UbiTrich/home-assistant-poe-satellite/hardware/dps_v0/pics/BakALLIN.png

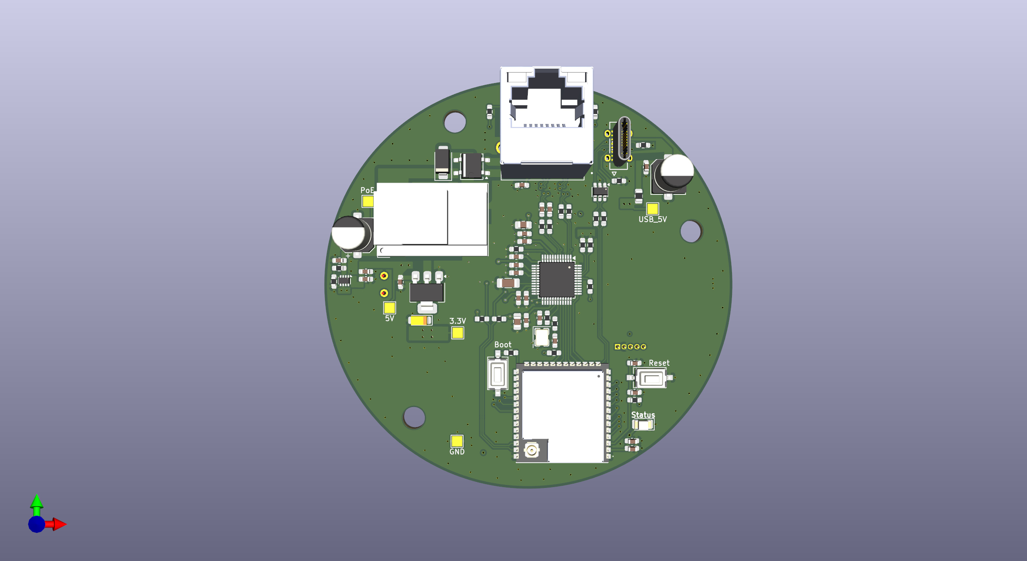
hardware/dps_v0/pics/BakALLIN.png
