UbiTrich/home-assistant-poe-satellite/hardware/dps_v0/pics/BakPOKUSYgg.png

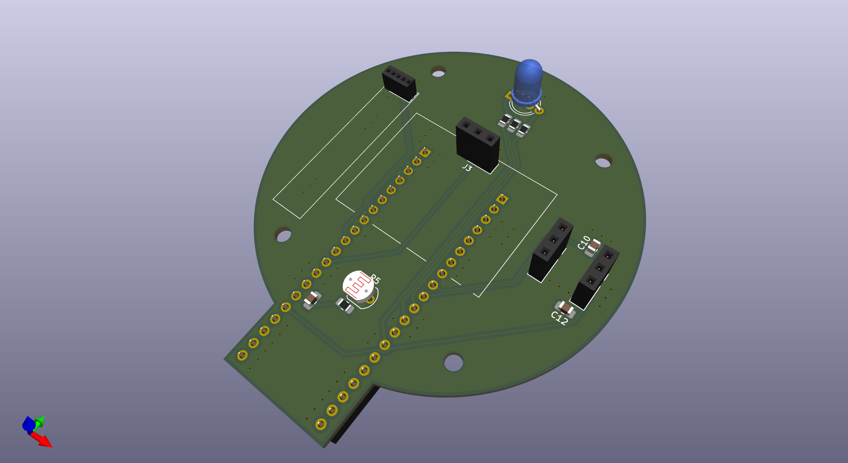
hardware/dps_v0/pics/BakPOKUSYgg.png
