UbiTrich/home-assistant-poe-satellite/hardware/dps_v0/dps_v0.png

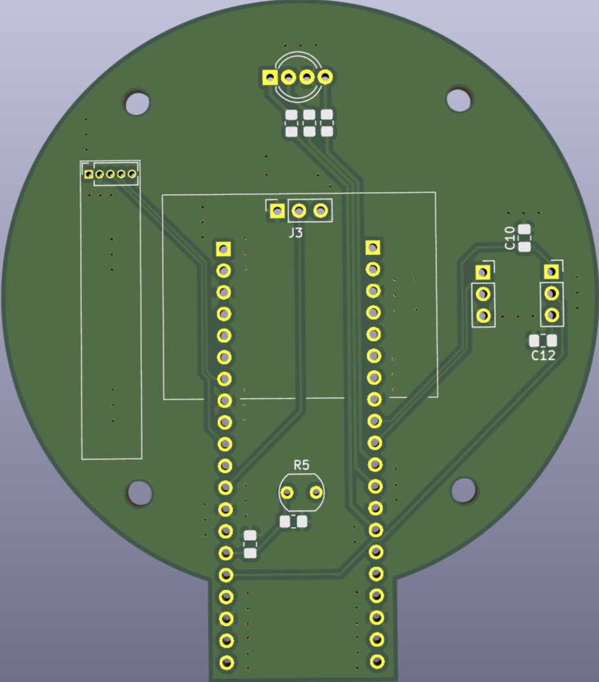
hardware/dps_v0/dps_v0.png
