UbiTrich/home-assistant-poe-satellite/hardware/dps_v0/pics/BAK.png

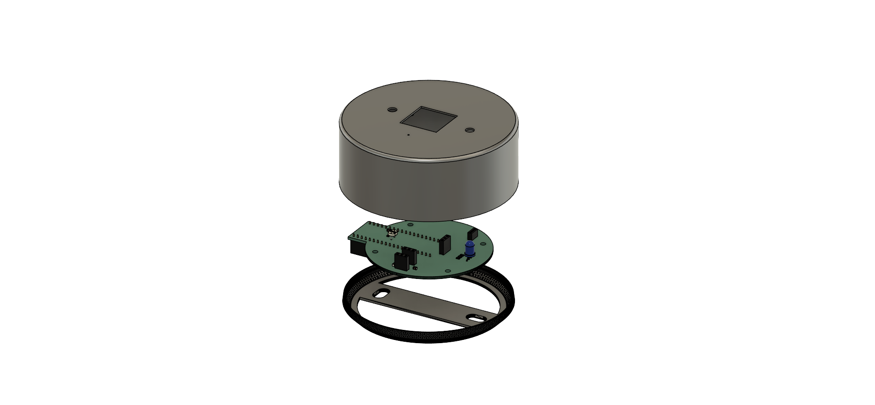
hardware/dps_v0/pics/BAK.png
