UbiTrich/home-assistant-poe-satellite/hardware/dps_v0/pics/BAKKK.png

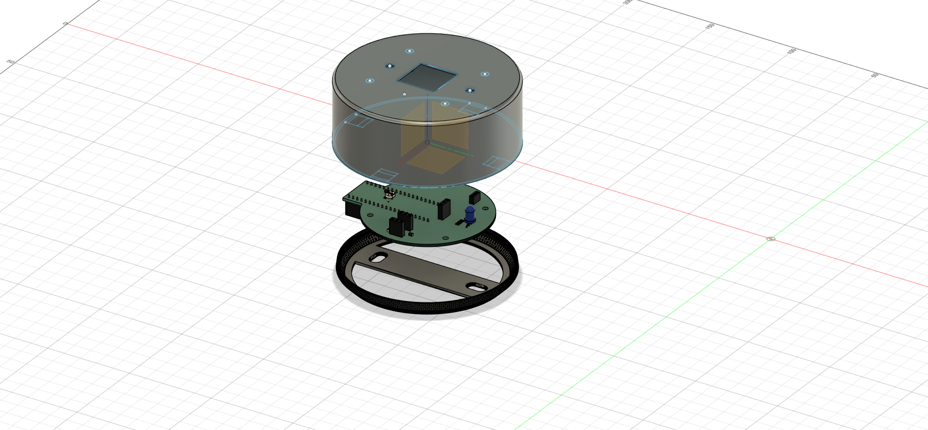
hardware/dps_v0/pics/BAKKK.png
