UbiTrich/home-assistant-poe-satellite/hardware/dps_v0/pics/schema_napajania.png

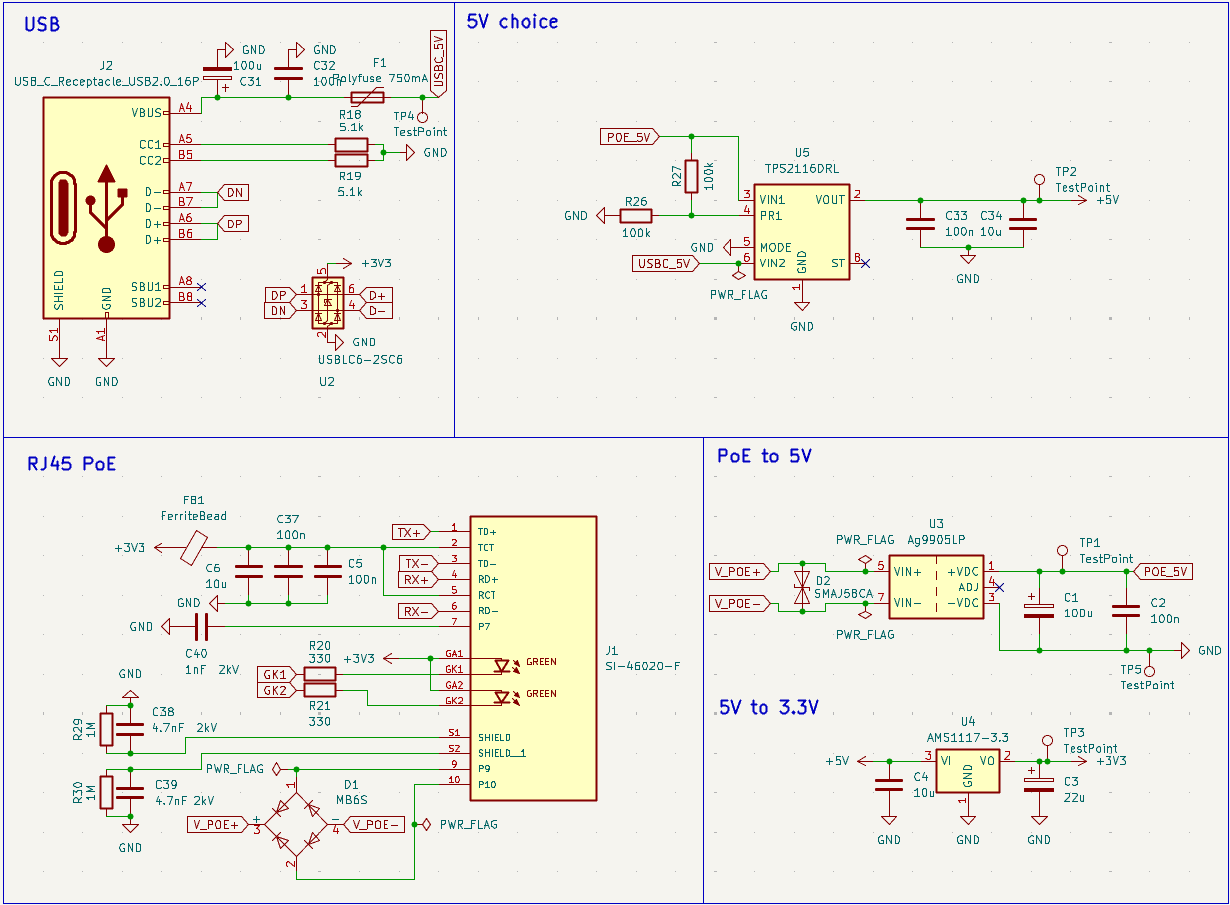
hardware/dps_v0/pics/schema_napajania.png
