UbiTrich/home-assistant-poe-satellite/hardware/dps_v0/pics/Screenshot 2026-03-11 211105.png

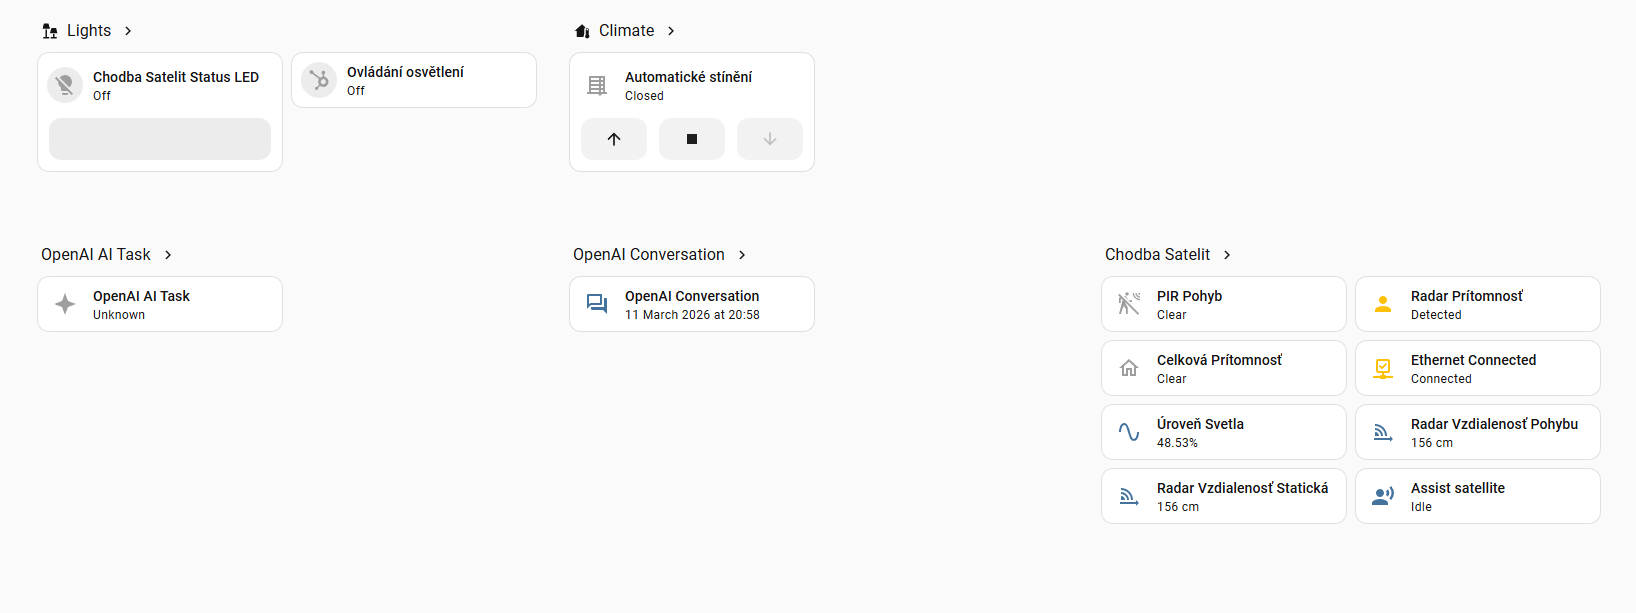
hardware/dps_v0/pics/Screenshot 2026-03-11 211105.png
