UbiTrich/home-assistant-poe-satellite/hardware/dps_v0/pics/Screenshot 2026-05-17 192225.png

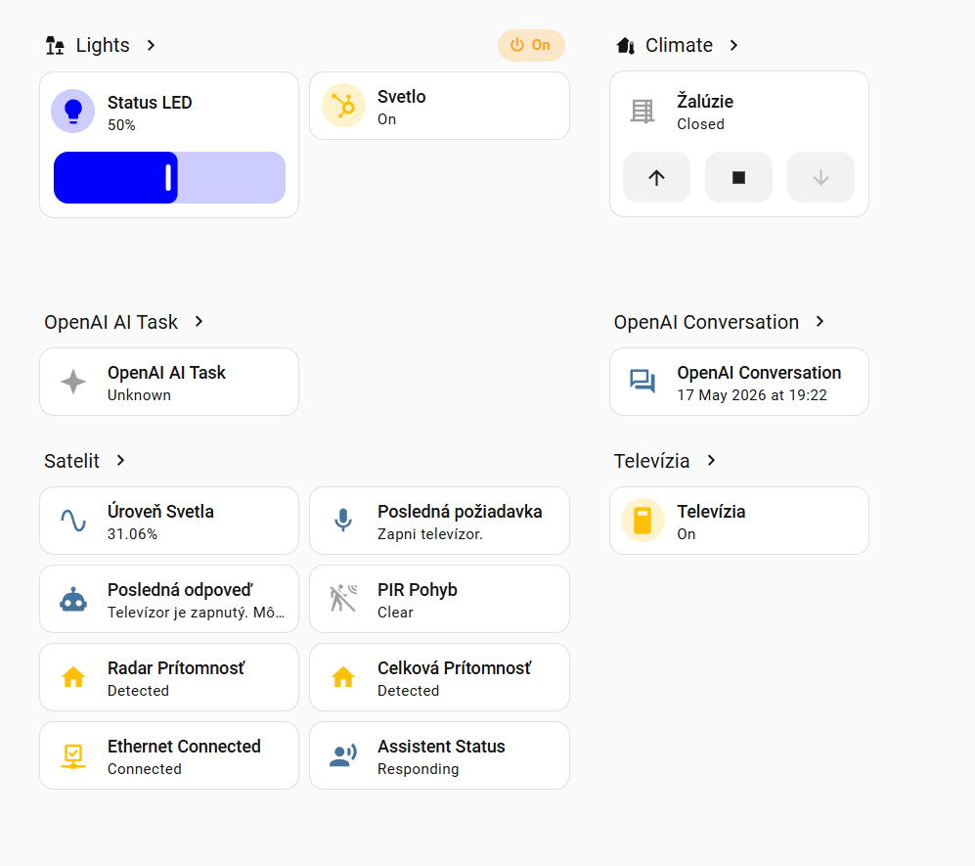
hardware/dps_v0/pics/Screenshot 2026-05-17 192225.png
