UbiTrich/home-assistant-poe-satellite/hardware/dps_v0/pics/W5500_Module.png

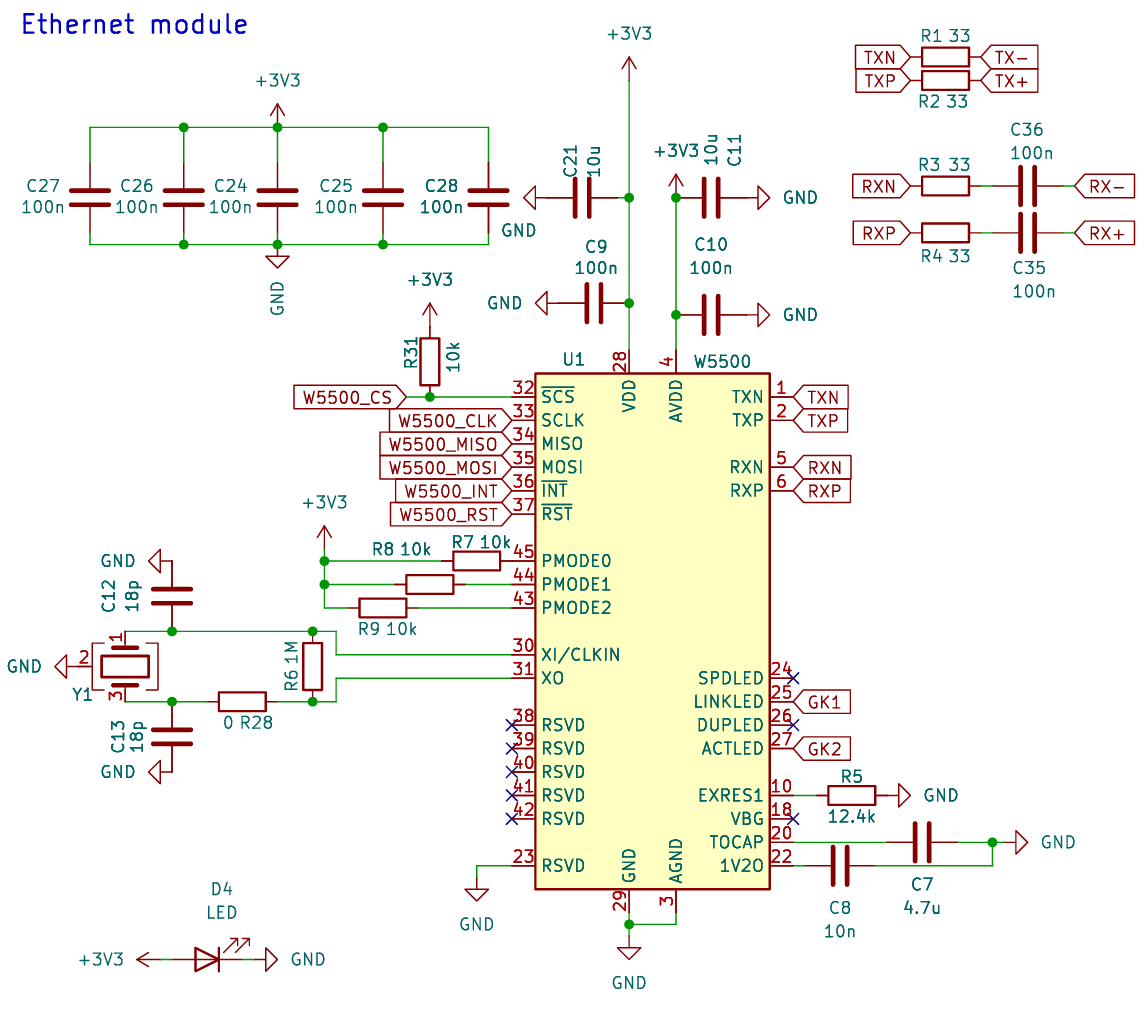
hardware/dps_v0/pics/W5500_Module.png
