UbiTrich/home-assistant-poe-satellite/enclosures/box_3d_model_print.stl

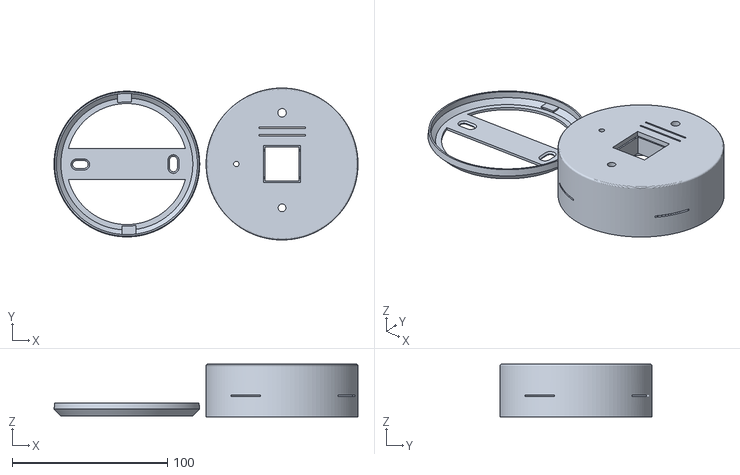
[picture p16: CAD file, 2026-05-22]
enclosures/box_3d_model_print.stl
196.0 x 98.0 x 34.0
