UbiTrich/home-assistant-poe-satellite/hardware/dps_v0/dps_v0.step

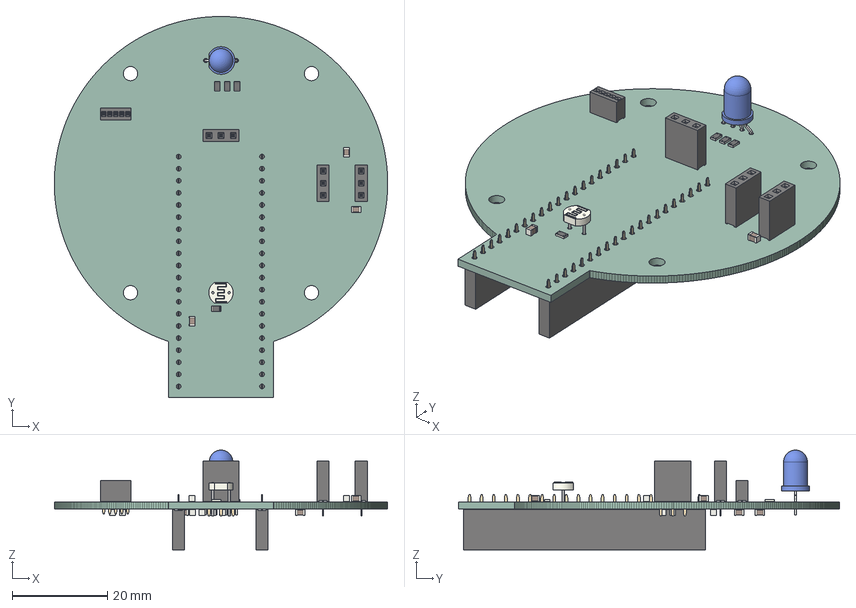
[picture p17: CAD file, 2026-05-29]
hardware/dps_v0/dps_v0.step
70.0 x 80.0 x 21.0 mm
C_0805_2012Metric x 12
PinSocket_1x03_P2.54mm_Vertical x 3
R_LDR_5.1x4.3mm_P3.4mm_Vertical
R_0805_2012Metric x 4
LED_D5.0mm-4_RGB_Wide_Pins
PinSocket_1x05_P1.27mm_Vertical
PinSocket_1x20_P2.54mm_Vertical x 2
BakPOKUSY_PCB
