UbiTrich/home-assistant-poe-satellite/hardware/dps_satelite/dps_satelite.pdf

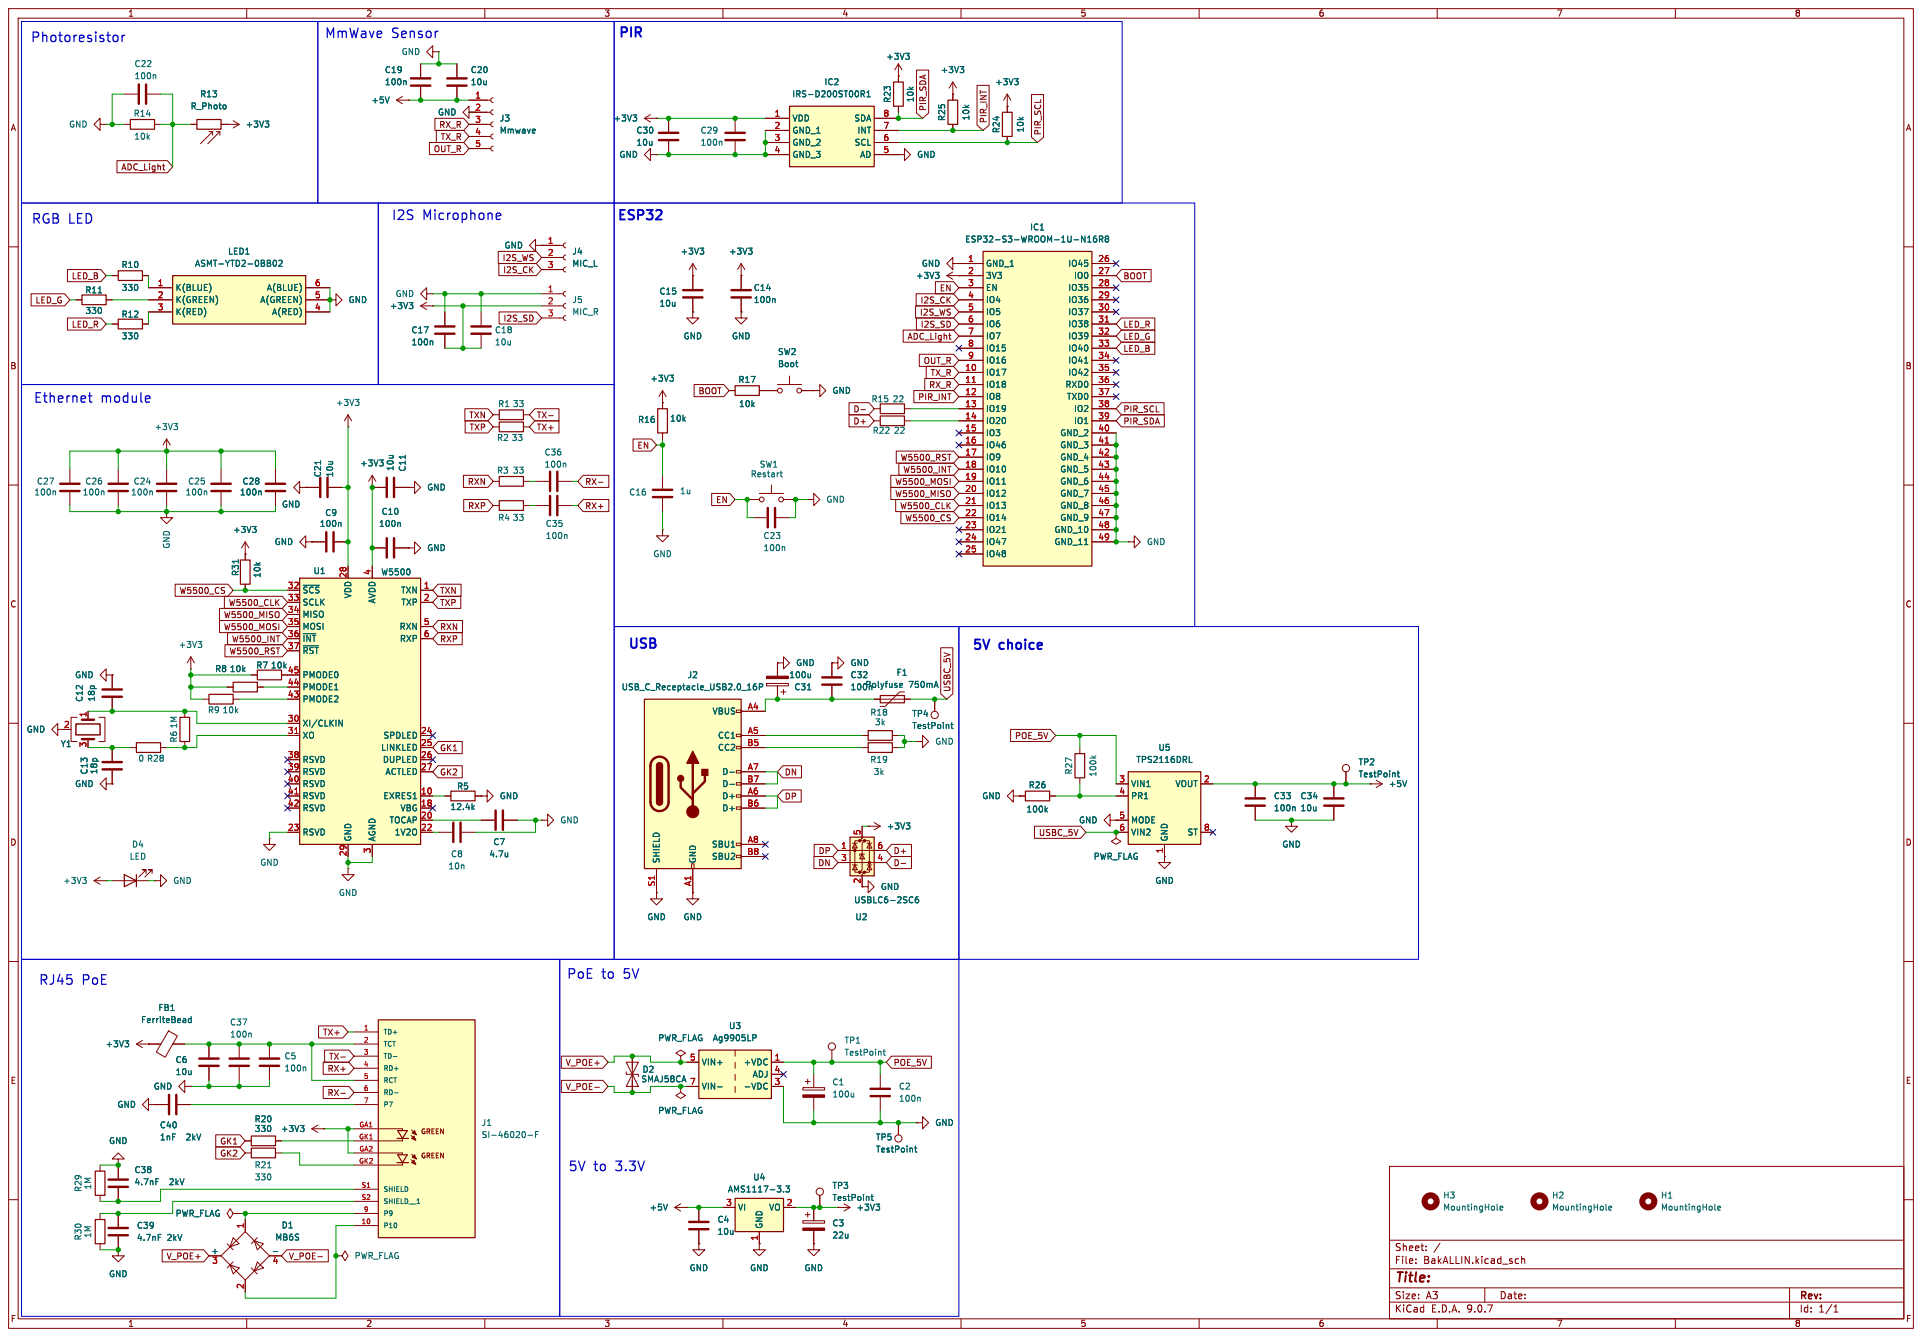
[picture p18: page 1]

3 TXN 1 TXP 2 RXN 5 RXP 6 SPDLED 24

LINKLED 25 DUPLED 26 ACTLED 27 EXRES1 10 VBG 18 TOCAP 20
