UbiTrich/home-assistant-poe-satellite/hardware/dps_satelite/Plot/dps_satelite.pdf

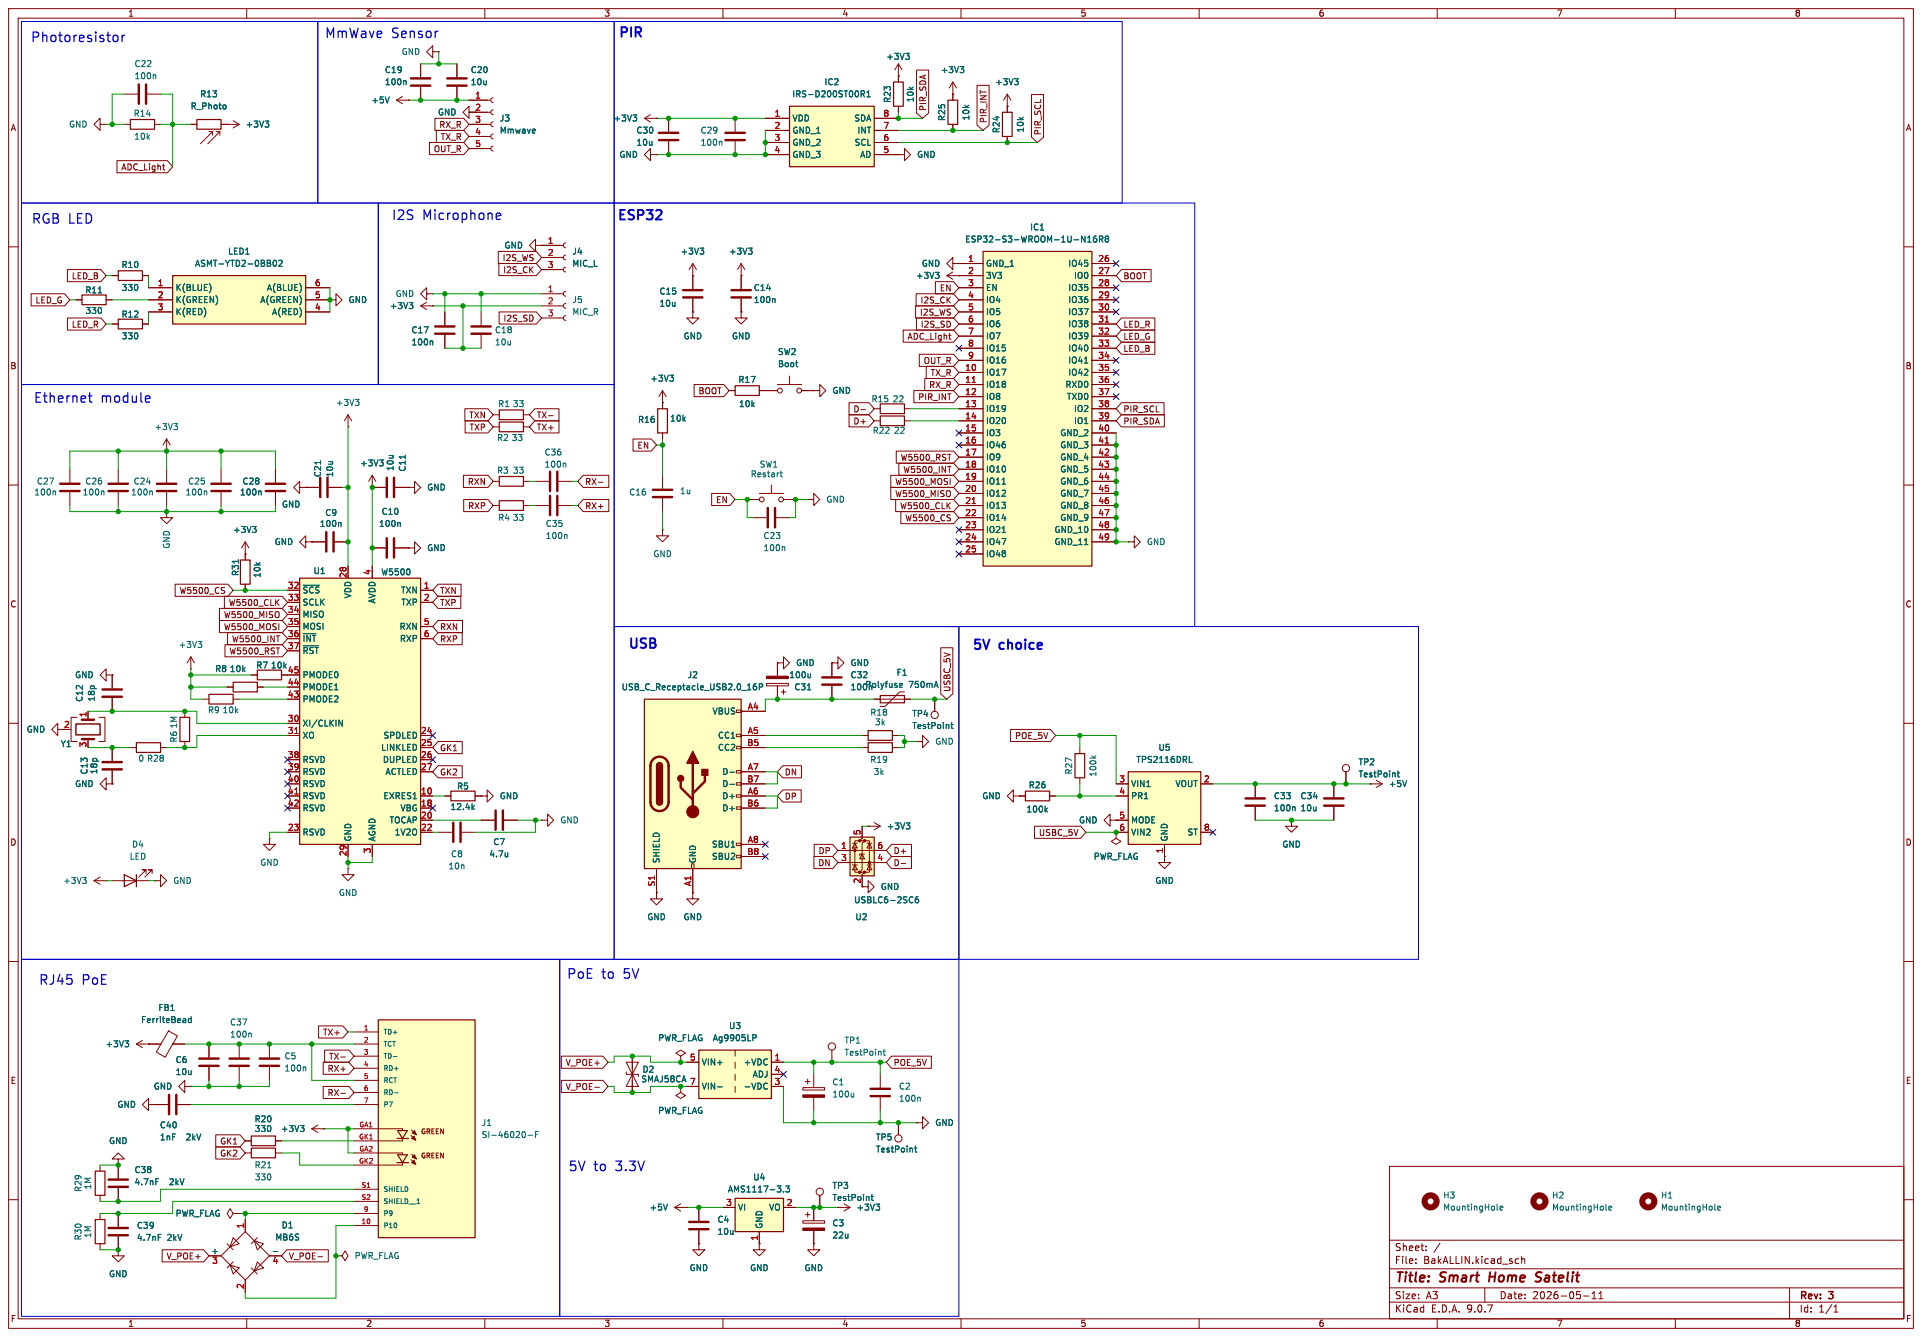
[picture p19: page 1]

3 TXN 1 TXP 2 RXN 5 RXP 6 SPDLED 24
