UbiTrich/home-assistant-poe-satellite/hardware/dps_v0/dps_v0.kicad_pcb

## KiCad design hardware/dps_v0/dps_v0.kicad_pcb (2026-05-29)

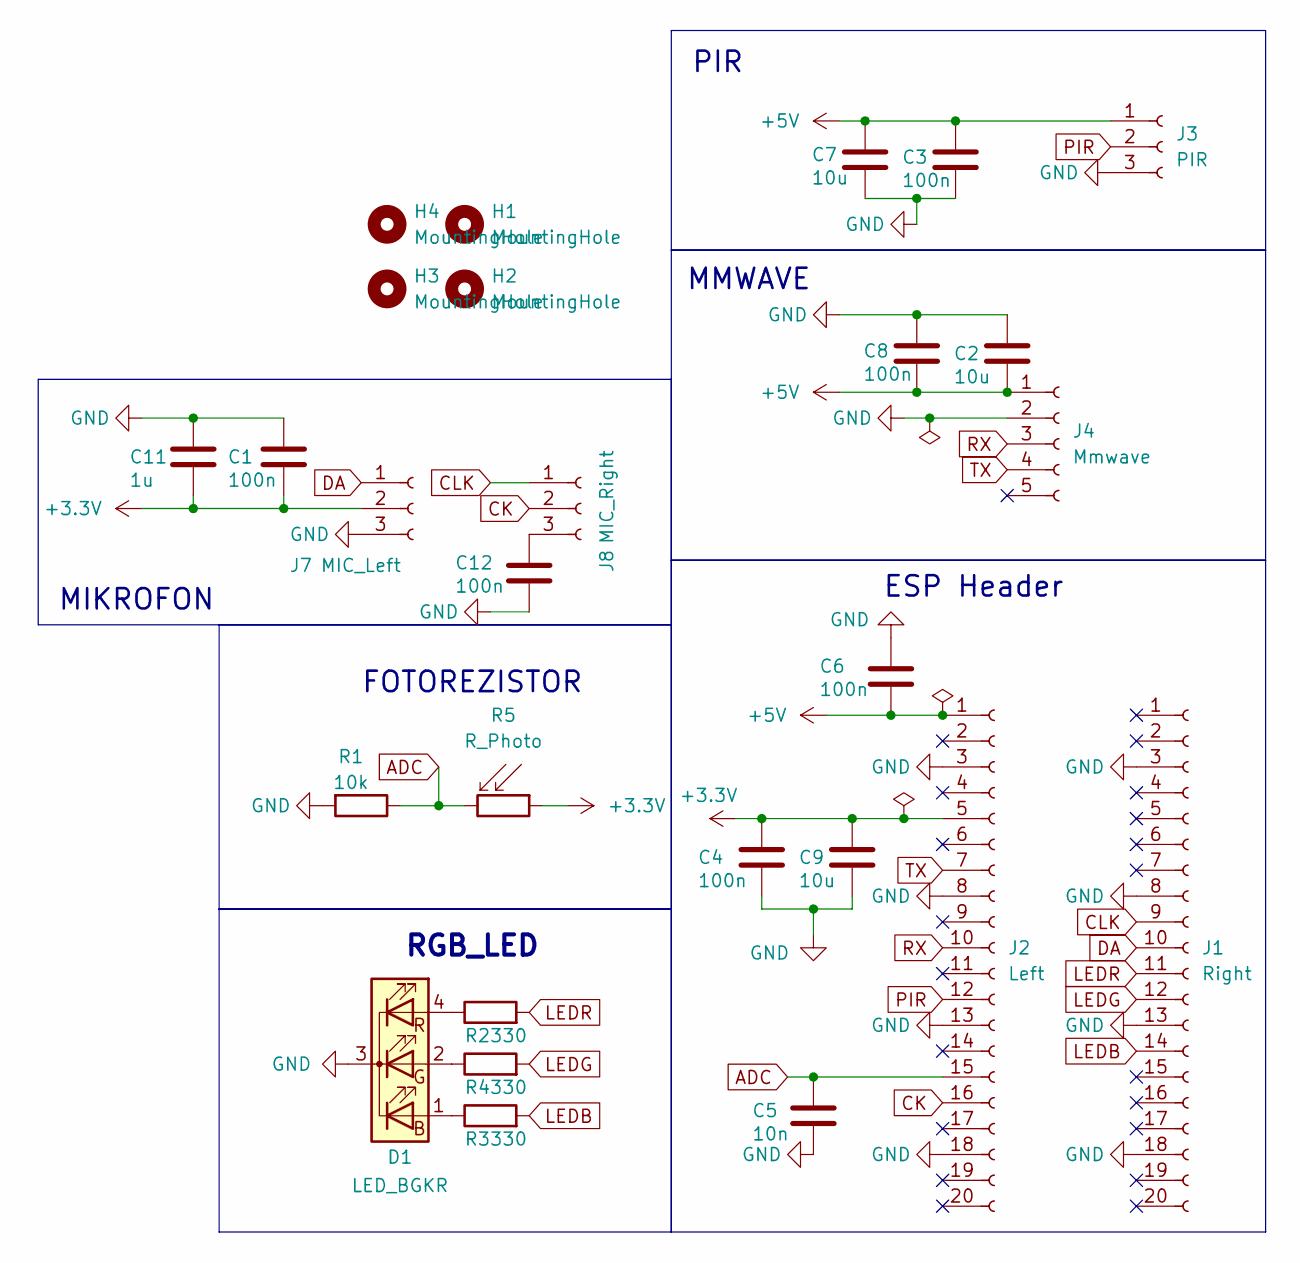
[picture p20: schematic dps_v0.kicad_sch]

Parts:
C1, C3, C4, C6, C8, C12: 100n; C_0805_2012Metric_Pad1.18x1.45mm_HandSolder
C2, C7, C9: 10u; C_0805_2012Metric_Pad1.18x1.45mm_HandSolder
C5: 10n; C_0805_2012Metric_Pad1.18x1.45mm_HandSolder
C11: 1u; C_0805_2012Metric_Pad1.18x1.45mm_HandSolder
D1: LED_BGKR; LED_D5.0mm-4_RGB_Wide_Pins
H1, H2, H3, H4: MountingHole; MountingHole_3mm
J1: Right; PinSocket_1x20_P2.54mm_Vertical
J2: Left; PinSocket_1x20_P2.54mm_Vertical
J3: PIR; PinSocket_1x03_P2.54mm_Vertical
J4: Mmwave; PinSocket_1x05_P1.27mm_Vertical
J7: MIC_Left; PinSocket_1x03_P2.54mm_Vertical
J8: MIC_Right; PinSocket_1x03_P2.54mm_Vertical
R1: 10k; R_0805_2012Metric_Pad1.20x1.40mm_HandSolder
R2, R3, R4: 330; R_0805_2012Metric_Pad1.20x1.40mm_HandSolder
R5: R_Photo; R_LDR_5.1x4.3mm_P3.4mm_Vertical

Connections:
+3.3V: C1.1, C4.2, C9.2, C11.1, J2.5, J7.2, R5.1
+5V: C2.1, C3.2, C6.1, C7.2, C8.1, J2.1, J3.1, J4.1
ADC: C5.2, J2.15, R1.1, R5.2
CK: J2.16, J8.2
CLK: J1.9, J8.1
DA: J1.10, J7.1
GND: C1.2, C2.2, C3.1, C4.1, C5.1, C6.2, C7.1, C8.2, C9.1, C11.2, C12.1, D1.3 (K), J1.3, J1.8, J1.13, J1.18, J2.3, J2.8, J2.13, J2.18, J3.3, J4.2, J7.3, R1.2
LEDB: J1.14, R3.2
LEDG: J1.12, R4.2
LEDR: J1.11, R2.2
unnamed: D1.1 (BA), R3.1
unnamed: D1.2 (GA), R4.1
unnamed: D1.4 (RA), R2.1
unnamed: C12.2, J8.3
PIR: J2.12, J3.2
RX: J2.10, J4.3
TX: J2.7, J4.4

Notes on the sheet:
ESP Header
MMWAVE
FOTOREZISTOR
MIKROFON
RGB_LED
PIR

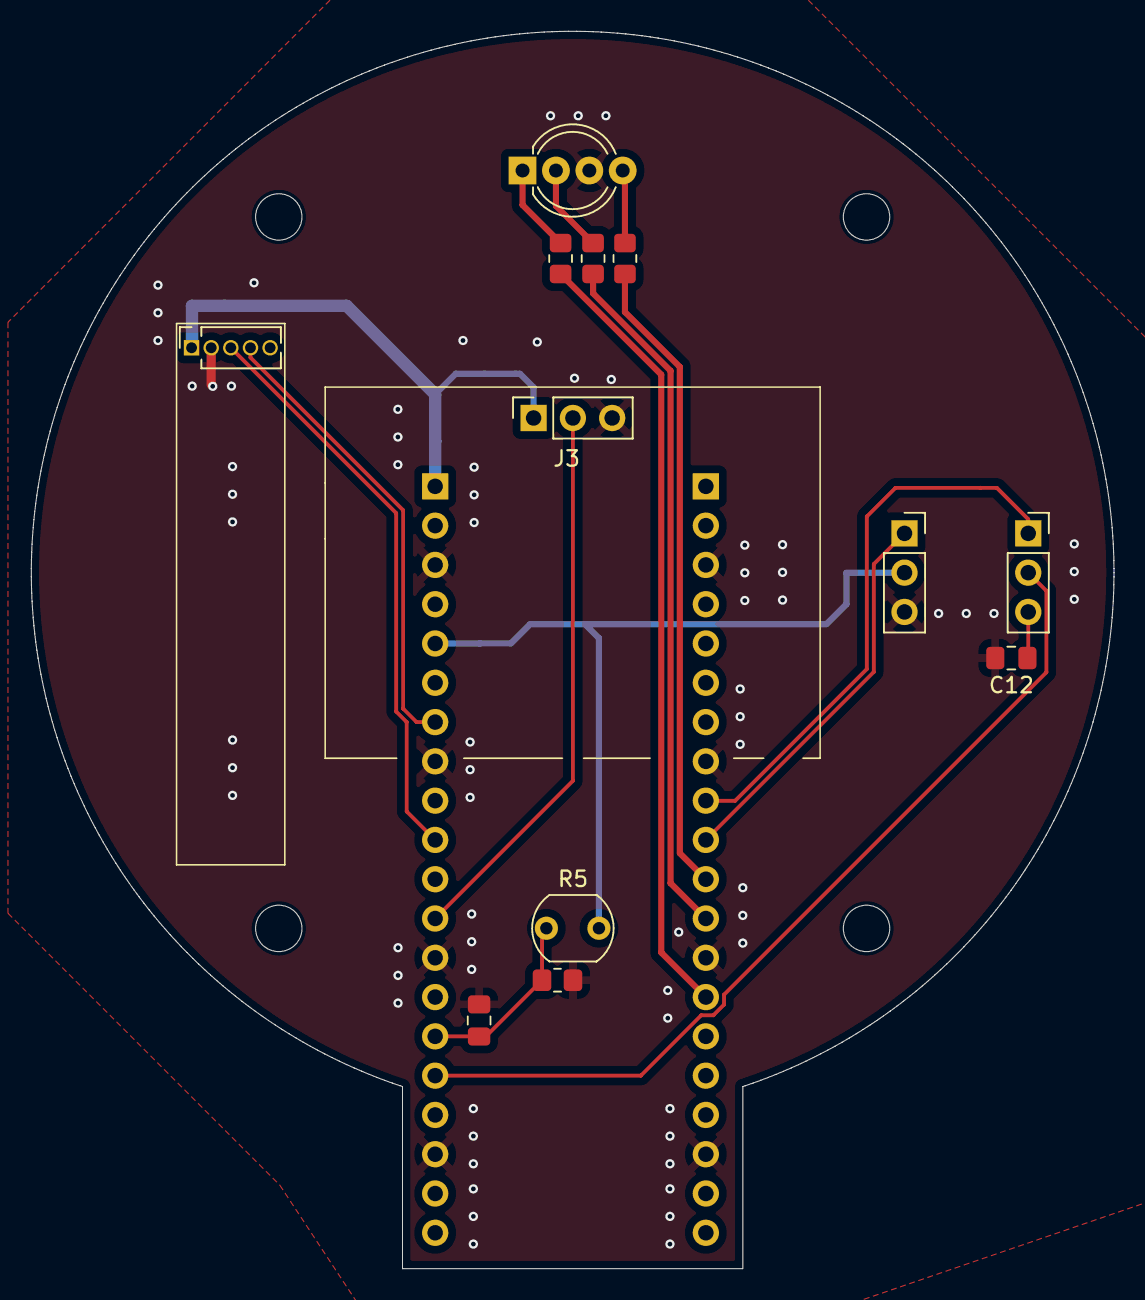
[picture p21: board dps_v0.kicad_pcb from above]

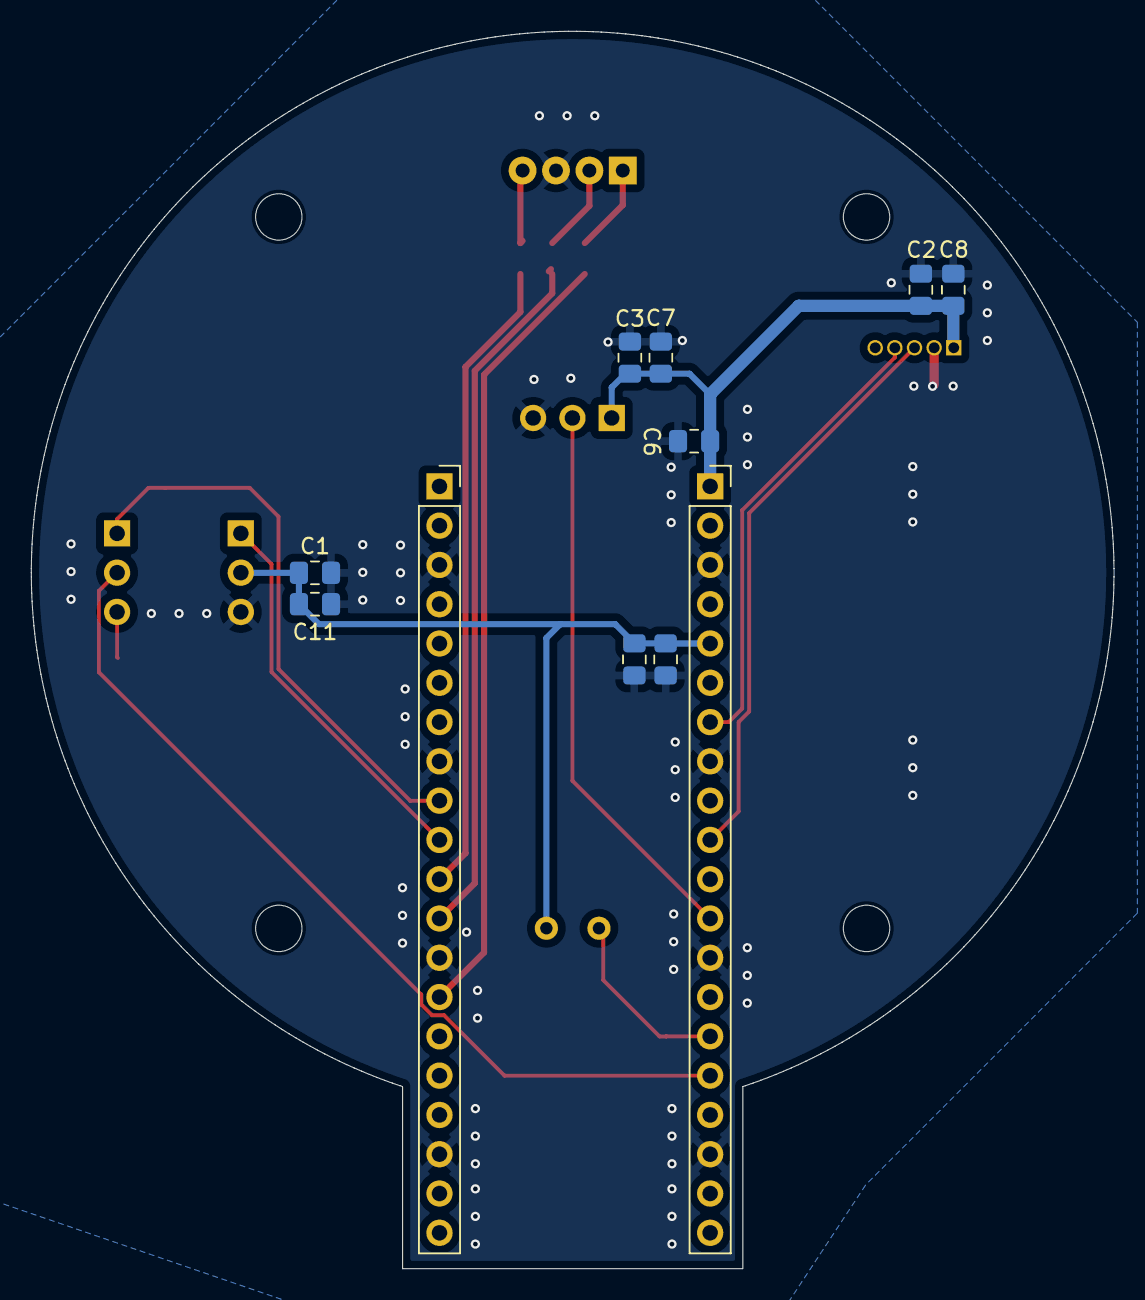
[picture p22: board dps_v0.kicad_pcb from below]

Board: 2 copper layers, 70.0 x 80.0 mm, 27 parts (11 on the bottom side), 17 nets.
