UbiTrich/home-assistant-poe-satellite/hardware/dps_satelite/dps_satelite.kicad_pcb

## KiCad design hardware/dps_satelite/dps_satelite.kicad_pcb (2026-05-22)

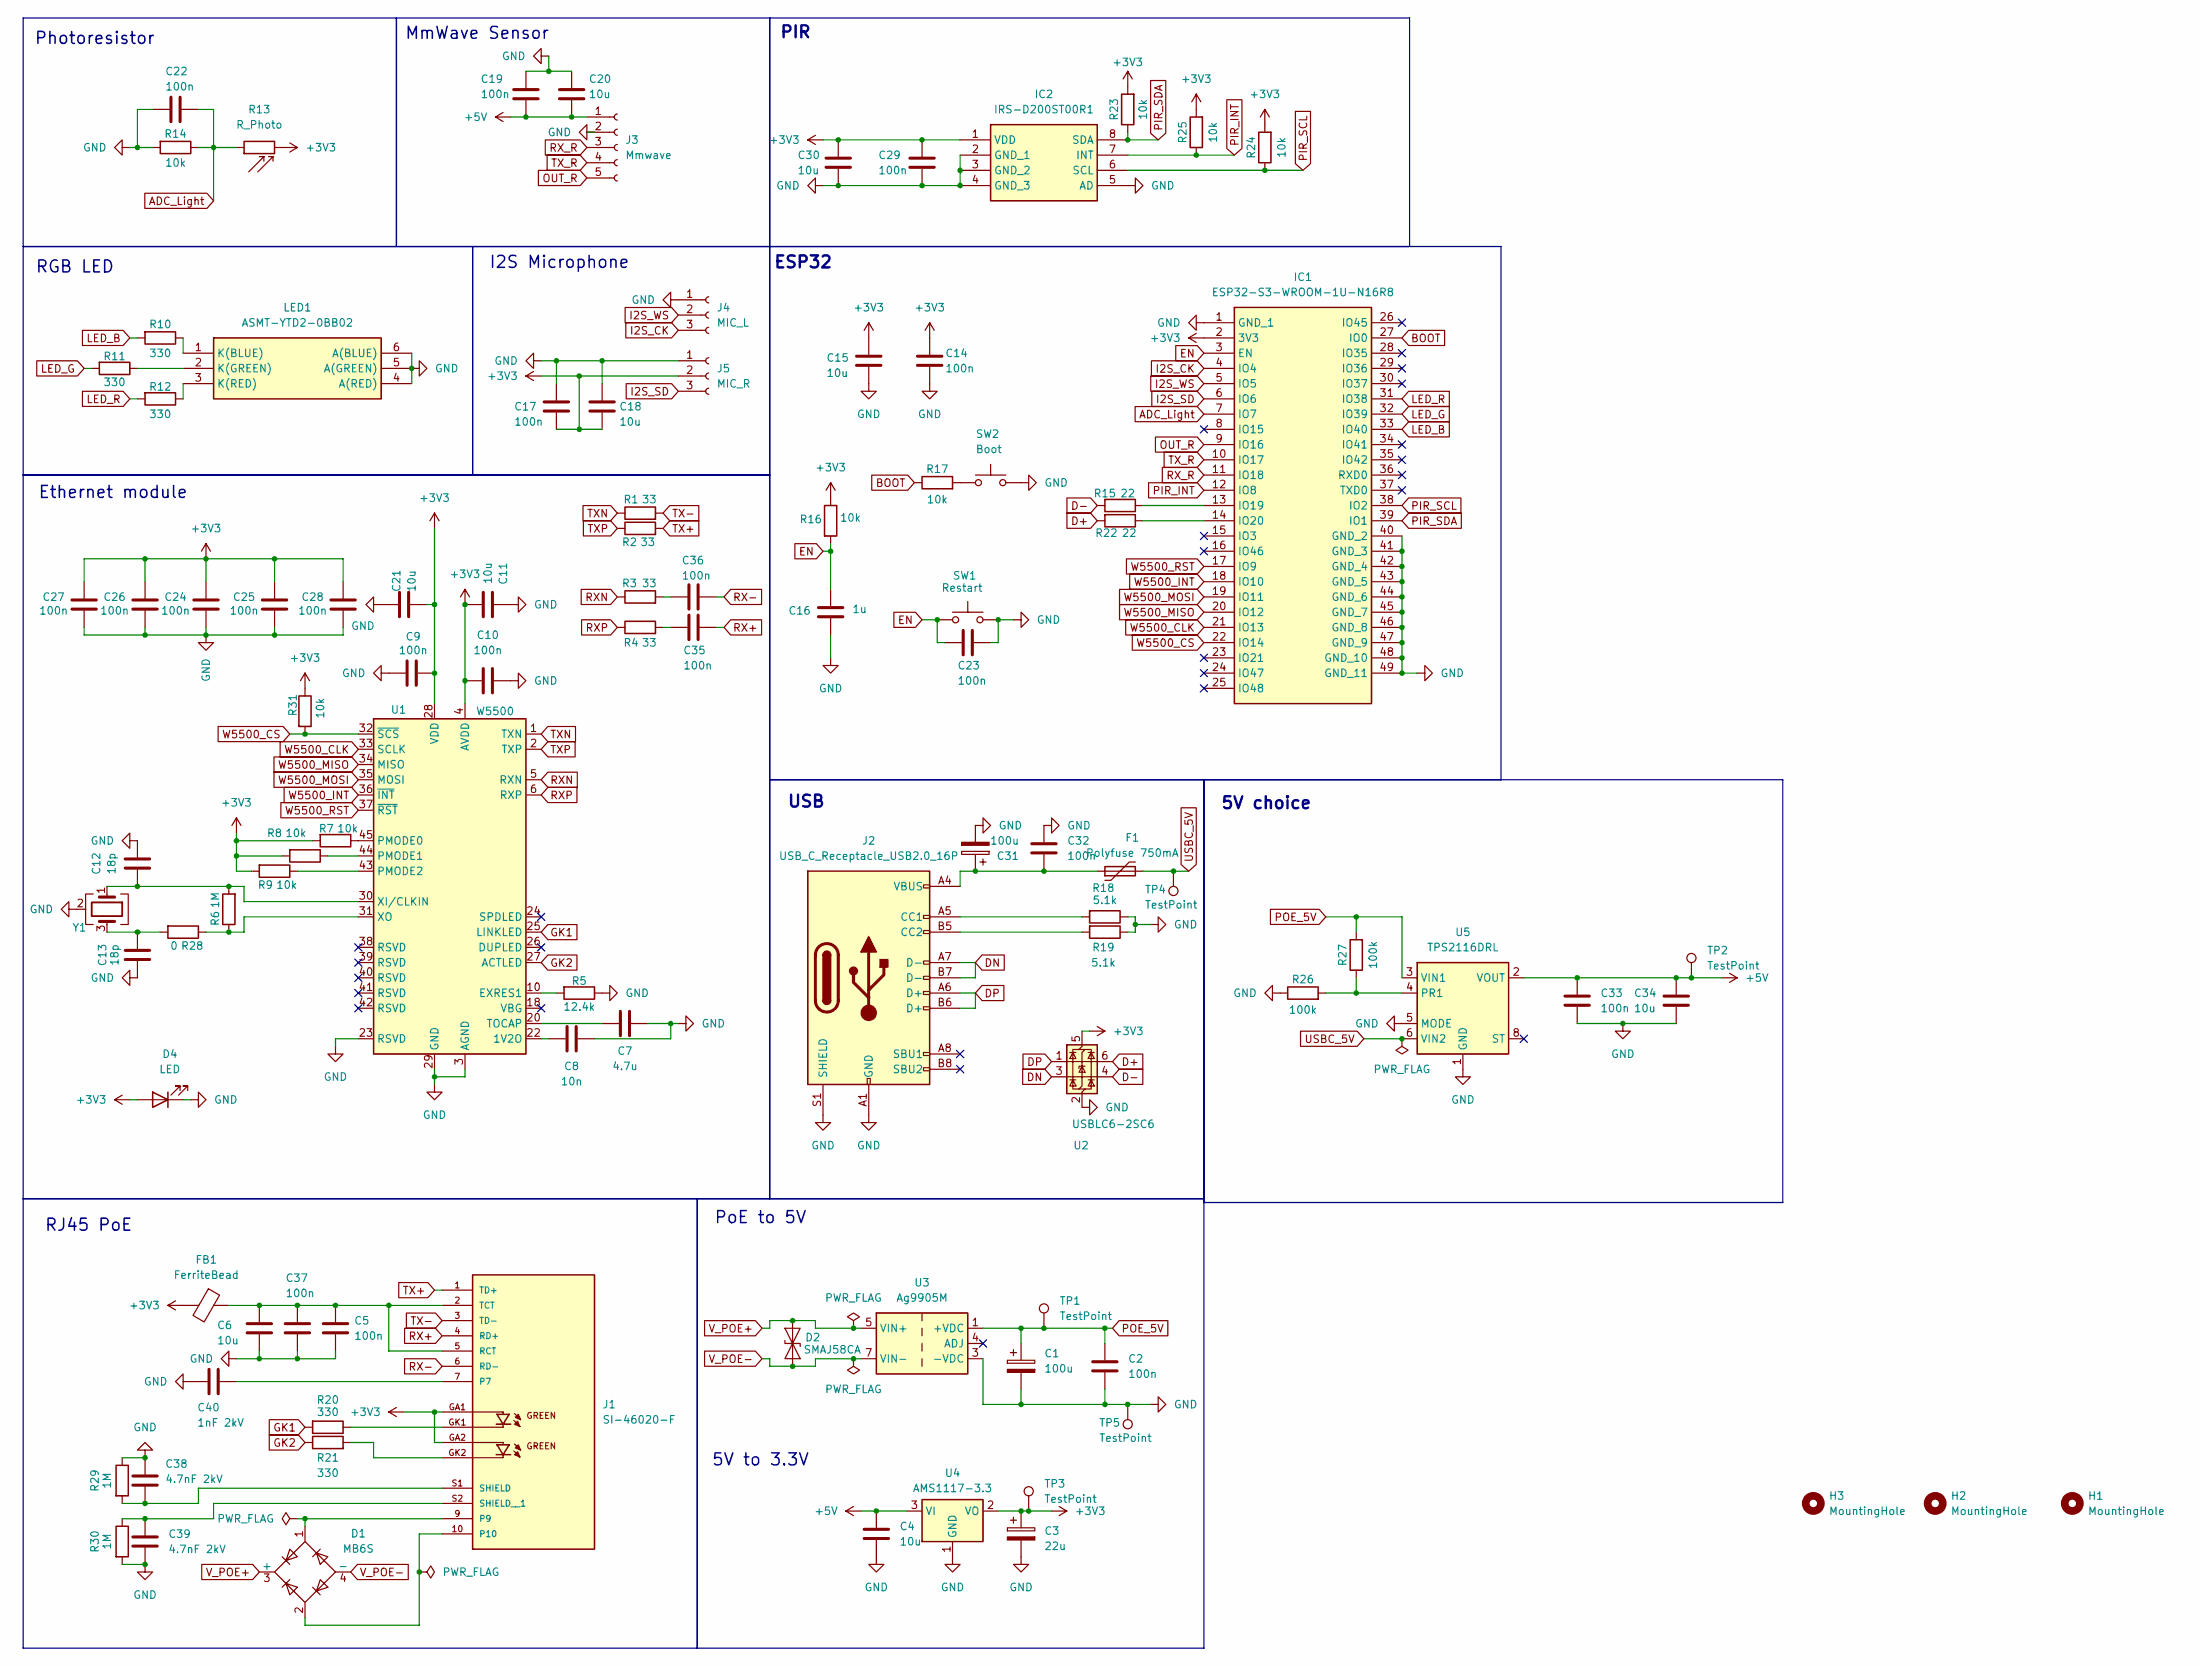
[picture p23: schematic dps_satelite.kicad_sch, Smart Home Satelit]

Parts:
C1, C31: 100u; CP_Elec_6.3x7.7
C2, C5, C9, C10, C14, C17, C19, C22, C23, C24, C25, C26, C27, C28, C29, C32, C33, C35, C36, C37: 100n; C_0603_1608Metric_Pad1.08x0.95mm_HandSolder
C3: 22u; CP_EIA-3216-10_Kemet-I_HandSolder
C4, C6, C15, C18, C20, C30, C34: 10u; C_0603_1608Metric_Pad1.08x0.95mm_HandSolder
C7: 4.7u; C_1206_3216Metric_Pad1.33x1.80mm_HandSolder
C8: 10n; C_0603_1608Metric_Pad1.08x0.95mm_HandSolder
C11, C21: 10u; C_0805_2012Metric_Pad1.18x1.45mm_HandSolder
C12, C13: 18p; C_0603_1608Metric_Pad1.08x0.95mm_HandSolder
C16: 1u; C_0603_1608Metric_Pad1.08x0.95mm_HandSolder
C38, C39: 4.7nF 2kV; C_0603_1608Metric_Pad1.08x0.95mm_HandSolder
C40: 1nF 2kV; C_0603_1608Metric_Pad1.08x0.95mm_HandSolder
D1: MB6S; TO-269AA
D2: SMAJ58CA; D_SMA
D4: LED; LED_1206_3216Metric
F1: Polyfuse 750mA; Fuse_0805_2012Metric
FB1: FerriteBead; C_0805_2012Metric_Pad1.18x1.45mm_HandSolder
H1, H2, H3: MountingHole; MountingHole_4.3mm_M4
IC1: ESP32-S3-WROOM-1U-N16R8; ESP32S3WROOM1UN16R8; Mouser Part Number 356-ESP32S3WM1UN16R8
IC2: IRS-D200ST00R1; IRSD200ST00R1; Manufacturer_Part_Number IRS-D200ST00R1
J1: SI-46020-F; BEL_SI-46020-F; PARTREV C
J2: USB_C_Receptacle_USB2.0_16P; MOLEX_2171820001
J3: Mmwave; PinSocket_1x05_P1.27mm_Vertical
J4: MIC_L; PinHeader_1x03_P2.54mm_Vertical_SMD_Pin1Right
J5: MIC_R; PinHeader_1x03_P2.54mm_Vertical_SMD_Pin1Right
LED1: ASMT-YTD2-0BB02; ASMTYTD20BB02; Mouser Part Number 630-ASMT-YTD2-0BB02
R1, R2, R3, R4: 33; R_0603_1608Metric_Pad0.98x0.95mm_HandSolder
R5: 12.4k; R_0603_1608Metric_Pad0.98x0.95mm_HandSolder
R6, R29, R30: 1M; R_0603_1608Metric_Pad0.98x0.95mm_HandSolder
R7, R8, R9, R14, R16, R17, R23, R24, R25, R31: 10k; R_0603_1608Metric_Pad0.98x0.95mm_HandSolder
R10, R11, R12, R20, R21: 330; R_0603_1608Metric_Pad0.98x0.95mm_HandSolder
R13: R_Photo; R_LDR_5.1x4.3mm_P3.4mm_Vertical
R15, R22: 22; R_0603_1608Metric_Pad0.98x0.95mm_HandSolder
R18, R19: 5.1k; R_0603_1608Metric_Pad0.98x0.95mm_HandSolder
R26, R27: 100k; R_0603_1608Metric_Pad0.98x0.95mm_HandSolder
R28: 0; R_0603_1608Metric_Pad0.98x0.95mm_HandSolder
SW1: Restart; SW_Tactile_SPST_NO_Straight_CK_PTS636Sx25SMTRLFS
SW2: Boot; SW_Tactile_SPST_NO_Straight_CK_PTS636Sx25SMTRLFS
TP1, TP2, TP3, TP4, TP5: TestPoint; TestPoint_Pad_2.0x2.0mm
U1: W5500; LQFP-48_7x7mm_P0.5mm
U2: USBLC6-2SC6; SOT-23-6
U3: Ag9905M; Converter_DCDC_Silvertel_Ag99xxLP_THT
U4: AMS1117-3.3; SOT-223-3_TabPin2
U5: TPS2116DRL; SOT-583-8
Y1: Crystal_GND24; Crystal_SMD_3225-4Pin_3.2x2.5mm

Connections:
+3V3: C3.1, C9.2, C10.2, C11.2, C14.2, C15.1, C17.2, C18.2, C21.2, C24.2, C25.2, C26.2, C27.2, C28.2, C29.1, C30.1, D4.2 (A), FB1.2, IC1.2 (3V3), IC2.1 (VDD), J1.GA1, J1.GA2, J5.2, R7.2, R8.2, R9.2, R13.2, R16.1, R23.2, R24.2, R25.2, R31.1, TP3.1, U1.4 (AVDD), U1.8 (AVDD), U1.11 (AVDD), U1.15 (AVDD), U1.17 (AVDD), U1.21 (AVDD), U1.28 (VDD), U2.5 (VBUS), U4.2 (VO)
+5V: C4.1, C19.2, C20.2, C33.1, C34.1, J3.1, TP2.1, U4.3 (VI), U5.2 (VOUT), U5.7 (VOUT)
ADC_Light: C22.1, IC1.7 (IO7), R13.1, R14.1
BOOT: IC1.27 (IO0), R17.1
D+: R22.2, U2.6 (I/O1)
D-: R15.2, U2.4 (I/O2)
DN: J2.A7 (D-), J2.B7 (D-), U2.3 (I/O2)
DP: J2.A6 (D+), J2.B6 (D+), U2.1 (I/O1)
EN: C16.2, C23.1, IC1.3 (EN), R16.2, SW1.1
GK1: R20.2, U1.25 (LINKLED)
GK2: R21.1, U1.27 (ACTLED)
GND: C1.2, C2.2, C3.2, C4.2, C5.2, C6.2, C7.2, C8.2, C9.1, C10.1, C11.1, C12.1, C13.1, C14.1, C15.2, C16.1, C17.1, C18.1, C19.1, C20.1, C21.1, C22.2, C23.2, C24.1, C25.1, C26.1, C27.1, C28.1, C29.2, C30.2, C31.2, C32.1, C33.2, C34.2, C37.2, C38.1, C39.2, C40.2, D4.1 (K), IC1.1 (GND_1), IC1.40 (GND_2), IC1.41 (GND_3), IC1.42 (GND_4), IC1.43 (GND_5), IC1.44 (GND_6), IC1.45 (GND_7), IC1.46 (GND_8), IC1.47 (GND_9), IC1.48 (GND_10), IC1.49 (GND_11), IC2.2 (GND_1), IC2.3 (GND_2), IC2.4 (GND_3), IC2.5 (AD), J2.A1 (GND), J2.A12 (GND), J2.B1 (GND), J2.B12 (GND), J2.S1 (SHIELD), J3.2, J4.1, J5.1, LED1.4 (A(RED)), LED1.5 (A(GREEN)), LED1.6 (A(BLUE)), R5.1, R14.2, R18.1, R19.1, R26.1, R29.1, R30.2, SW1.2, SW2.2, TP5.1, U1.3 (AGND), U1.9 (AGND), U1.14 (AGND), U1.16 (AGND), U1.19 (AGND), U1.23 (RSVD), U1.29 (GND), U1.48 (AGND), U2.2 (GND), U3.3 (-VDC), U4.1 (GND), U5.1 (GND), U5.5 (MODE), Y1.2 (G), Y1.4 (G)
I2S_CK: IC1.4 (IO4), J4.3
I2S_SD: IC1.6 (IO6), J5.3
I2S_WS: IC1.5 (IO5), J4.2
LED_B: IC1.33 (IO40), R10.2
LED_G: IC1.32 (IO39), R11.2
LED_R: IC1.31 (IO38), R12.2
unnamed: C13.2, R28.2, Y1.3
unnamed: C31.1, C32.2, F1.1, J2.A4 (VBUS), J2.A9 (VBUS), J2.B4 (VBUS), J2.B9 (VBUS)
unnamed: C35.1, R4.2
unnamed: C36.1, R3.2
unnamed: IC1.13 (IO19), R15.1
unnamed: IC1.14 (IO20), R22.1
unnamed: C40.1, J1.7
unnamed: D1.1, J1.9
unnamed: D1.2, J1.10
unnamed: J1.GK1, R20.1
unnamed: J1.GK2, R21.2
unnamed: C5.1, C6.1, C37.1, FB1.1, J1.2 (TCT), J1.5 (RCT)
unnamed: C38.2, J1.S1 (SHIELD), R29.2
unnamed: C39.1, J1.S2 (SHIELD__1), R30.1
unnamed: J2.A5 (CC1), R18.2
unnamed: J2.B5 (CC2), R19.2
unnamed: LED1.1 (K(BLUE)), R10.1
unnamed: LED1.2 (K(GREEN)), R11.1
unnamed: LED1.3 (K(RED)), R12.1
unnamed: R17.2, SW2.1
unnamed: C8.1, U1.22 (1V2O)
unnamed: R5.2, U1.10 (EXRES1)
unnamed: R7.1, U1.45 (PMODE0)
unnamed: R8.1, U1.44 (PMODE1)
unnamed: R9.1, U1.43 (PMODE2)
unnamed: C7.1, U1.20 (TOCAP)
unnamed: C12.2, R6.2, U1.30 (XI/CLKIN), Y1.1
unnamed: R6.1, R28.1, U1.31 (XO)
unnamed: R26.2, R27.1, U5.4 (PR1)
OUT_R: IC1.9 (IO16), J3.5
PIR_INT: IC1.12 (IO8), IC2.7 (INT), R25.1
PIR_SCL: IC1.38 (IO2), IC2.6 (SCL), R24.1
PIR_SDA: IC1.39 (IO1), IC2.8 (SDA), R23.1
POE_5V: C1.1, C2.1, R27.2, TP1.1, U3.1 (+VDC), U3.2 (+VDC), U5.3 (VIN1)
RX+: C35.2, J1.4 (RD+)
RX-: C36.2, J1.6 (RD-)
RXN: R3.1, U1.5 (RXN)
RXP: R4.1, U1.6 (RXP)
RX_R: IC1.11 (IO18), J3.3
TX+: J1.1 (TD+), R2.2
TX-: J1.3 (TD-), R1.2
TXN: R1.1, U1.1 (TXN)
TXP: R2.1, U1.2 (TXP)
TX_R: IC1.10 (IO17), J3.4
USBC_5V: F1.2, TP4.1, U5.6 (VIN2)
V_POE+: D1.3 (+), D2.2 (A2), U3.5 (VIN+), U3.6 (VIN+)
V_POE-: D1.4 (-), D2.1 (A1), U3.7 (VIN-), U3.8 (VIN-)
W5500_CLK: IC1.21 (IO13), U1.33 (SCLK)
W5500_CS: IC1.22 (IO14), R31.2, U1.32 (~SCS)
W5500_INT: IC1.18 (IO10), U1.36 (~INT)
W5500_MISO: IC1.20 (IO12), U1.34 (MISO)
W5500_MOSI: IC1.19 (IO11), U1.35 (MOSI)
W5500_RST: IC1.17 (IO9), U1.37 (~RST)

Notes on the sheet:
PoE to 5V
USB
MmWave Sensor
Ethernet module
5V choice
5V to 3.3V
RJ45 PoE
PIR
I2S Microphone
ESP32
Photoresistor
RGB LED

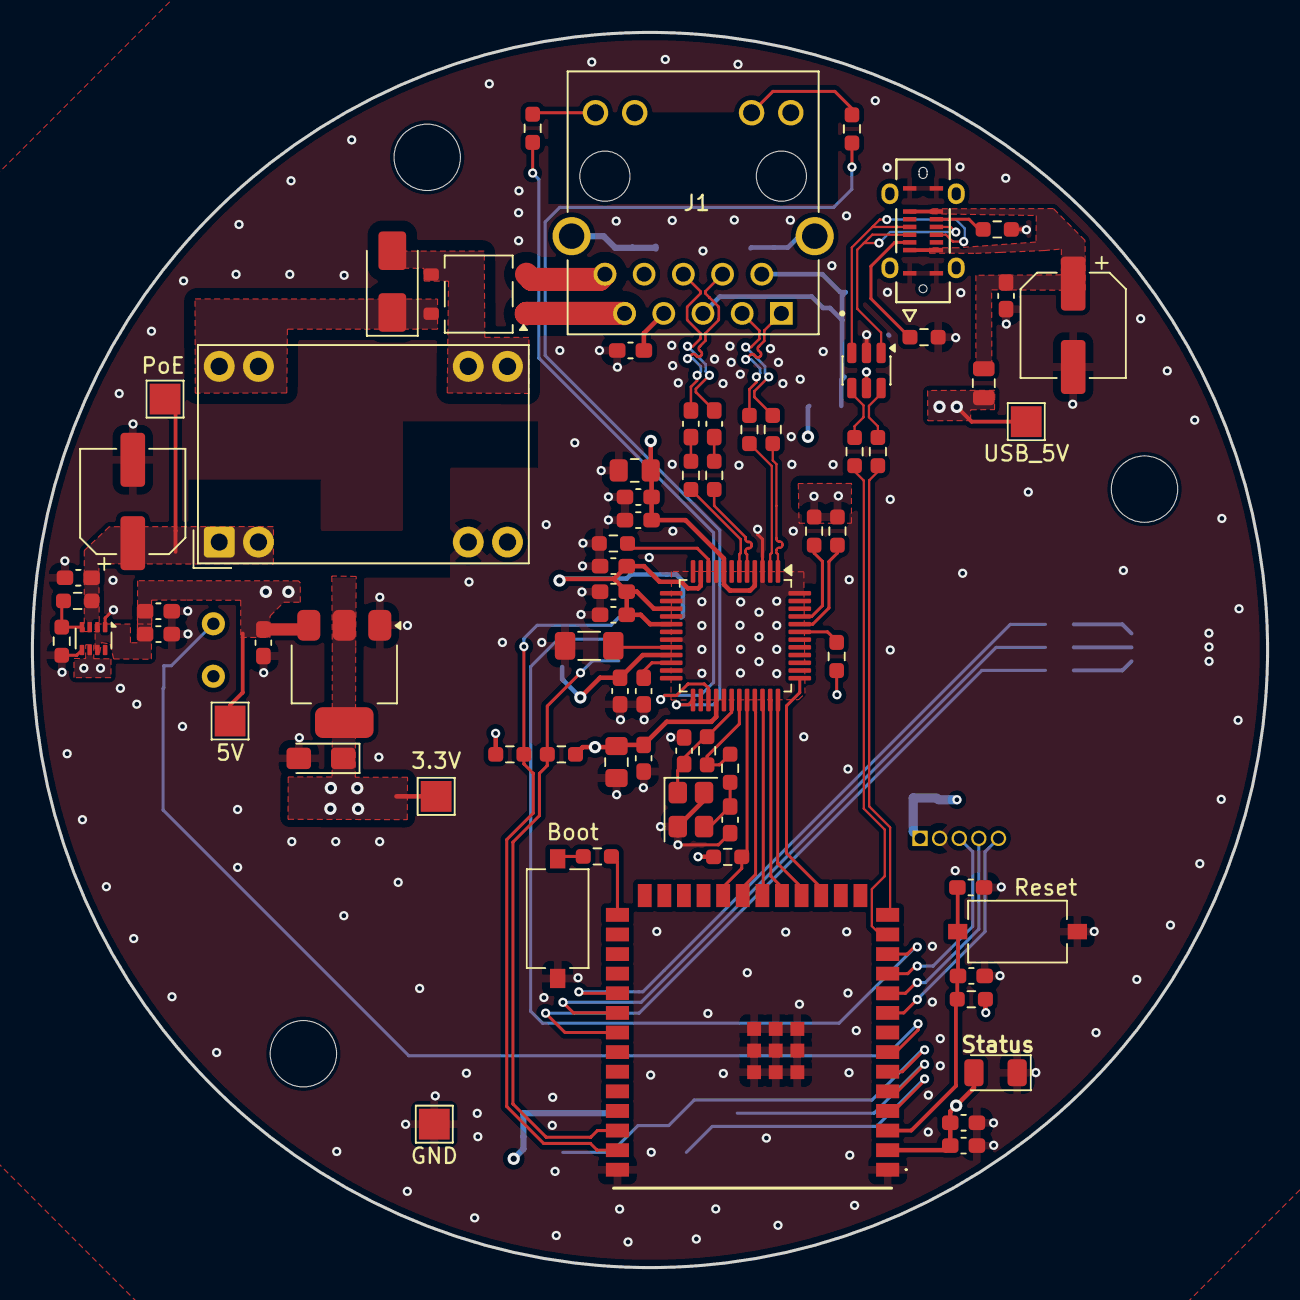
[picture p24: board dps_satelite.kicad_pcb from above]

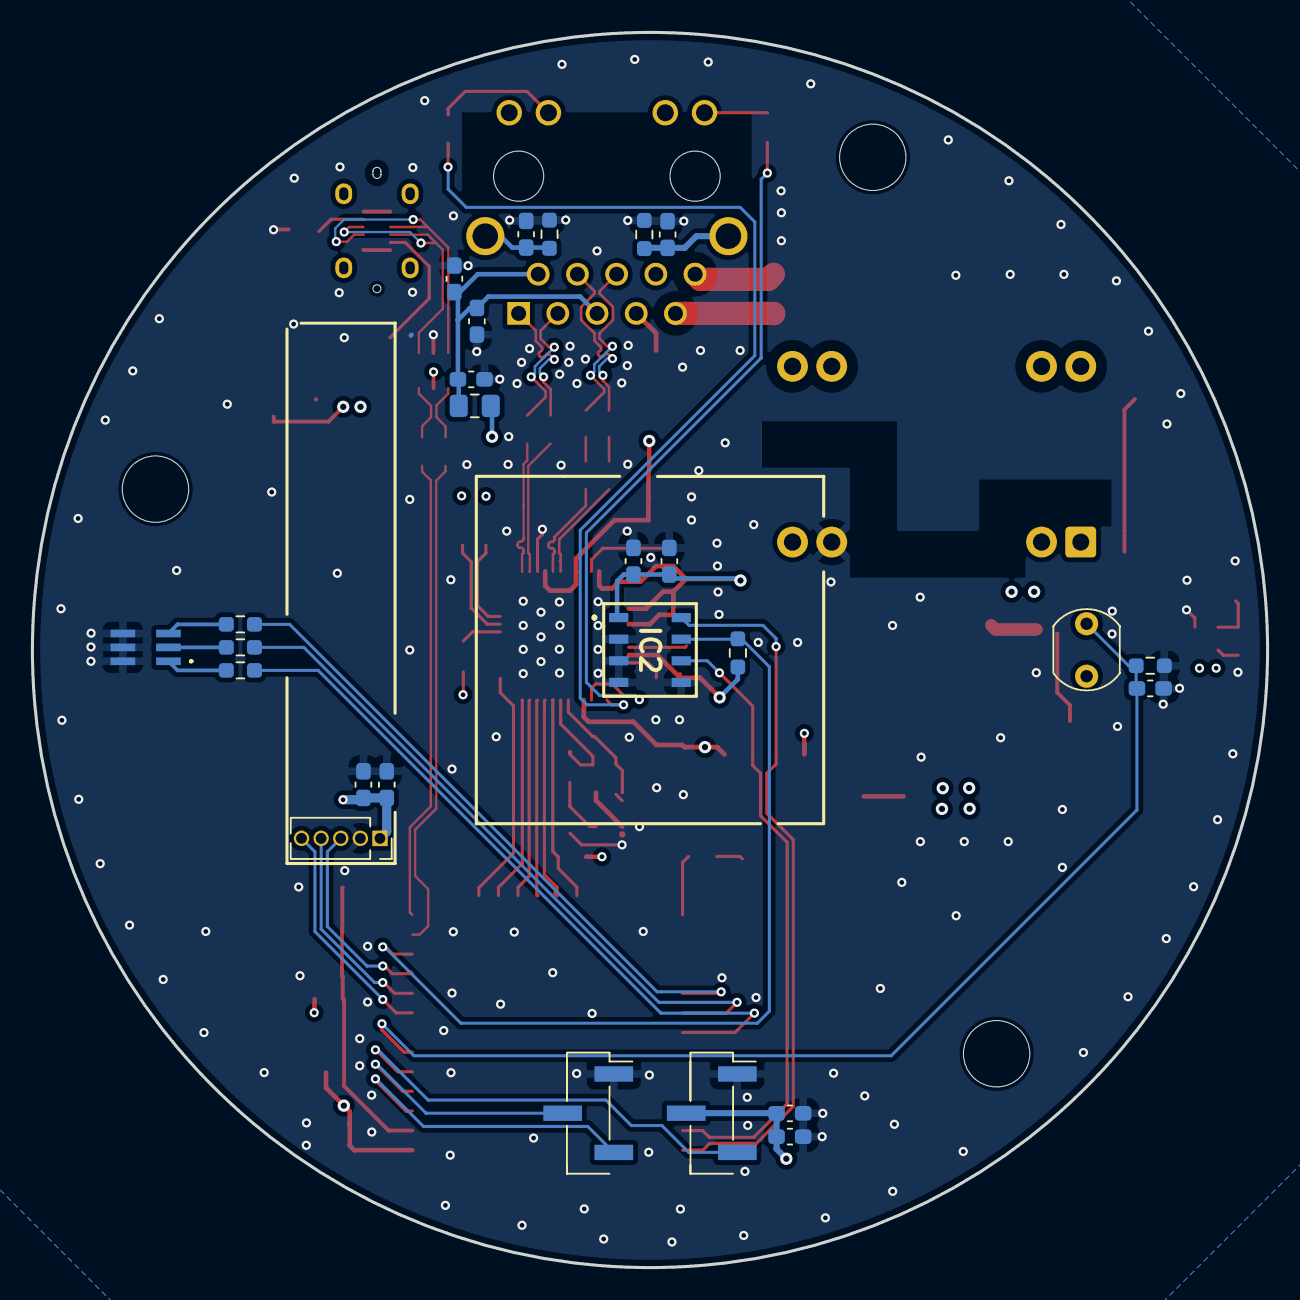
[picture p25: board dps_satelite.kicad_pcb from below]

Board: 4 copper layers, 80.0 x 80.0 mm, 100 parts (26 on the bottom side), 71 nets.
