UbiTrich/home-assistant-poe-satellite/(commit log)

2026-05-22 Initial commit - hardware and firmware files
    [bom.csv, box_3d_model_print.stl, designators.csv, dps_satelite.csv, dps_satelite.kicad_pcb, dps_satelite.kicad_sch, positions.csv]
2026-05-29 vO dps and raw code added
    [dps_v0.kicad_pcb, dps_v0.kicad_sch, dps_v0.step, latencia_merania.xlsx]
